Pinoccio/test-backpack-wifi/eagle/wifi-test-middle.pdf

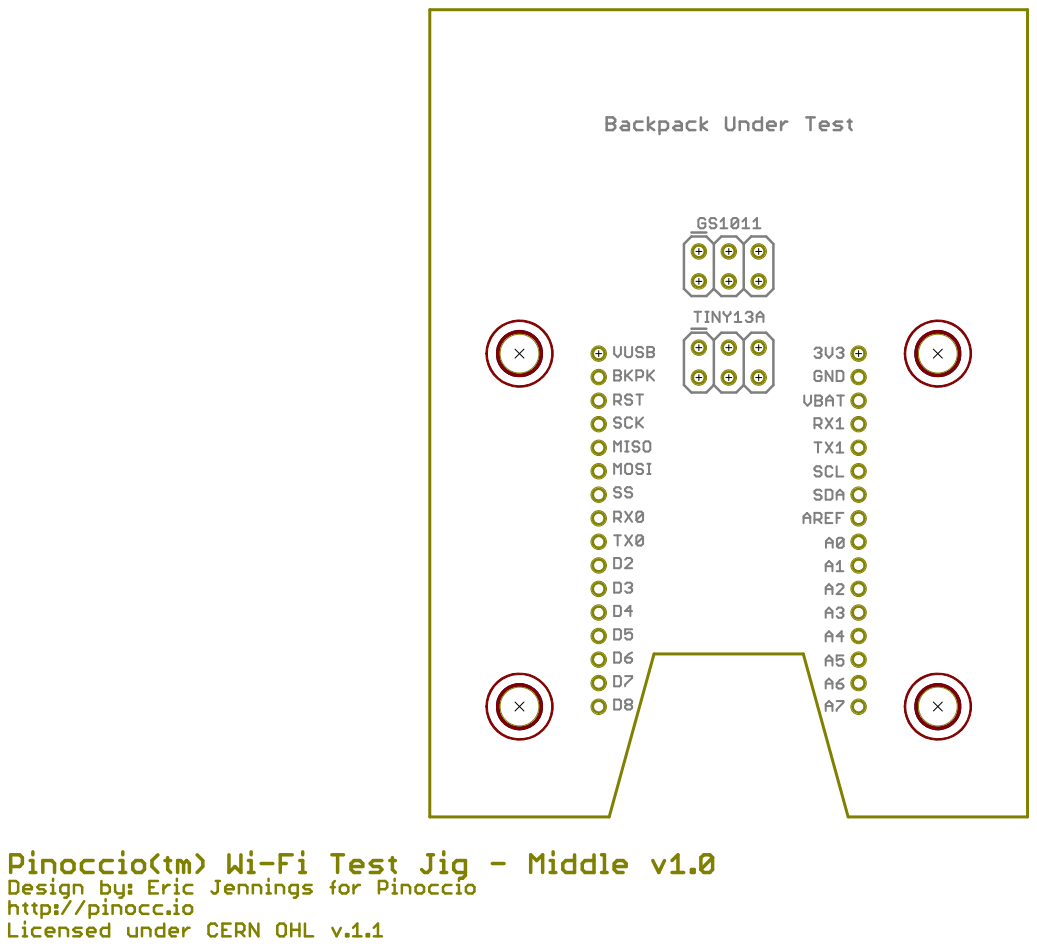
[picture p1: page 1]
