Pinoccio/test-backpack-wifi/eagle/wifi-test-top.pdf

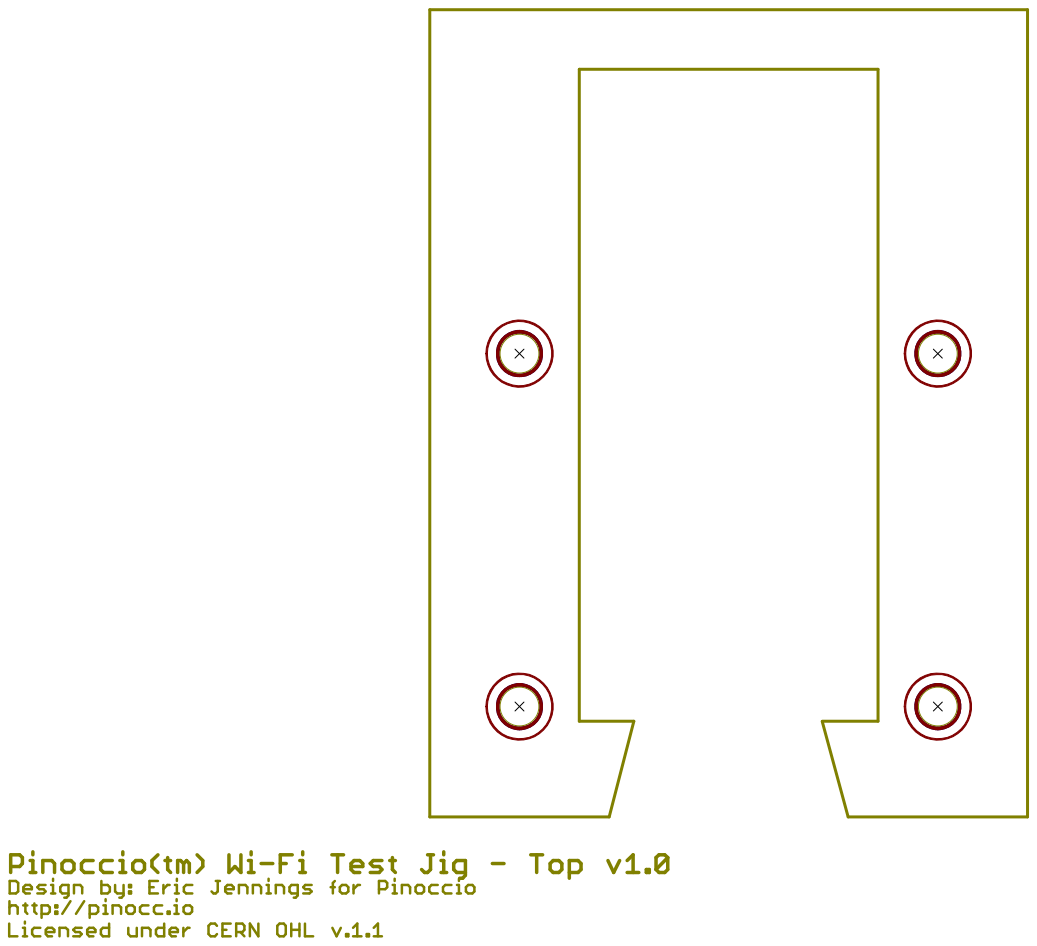
[picture p2: page 1]
