Pinoccio/test-backpack-wifi/eagle/wifi-test.pdf

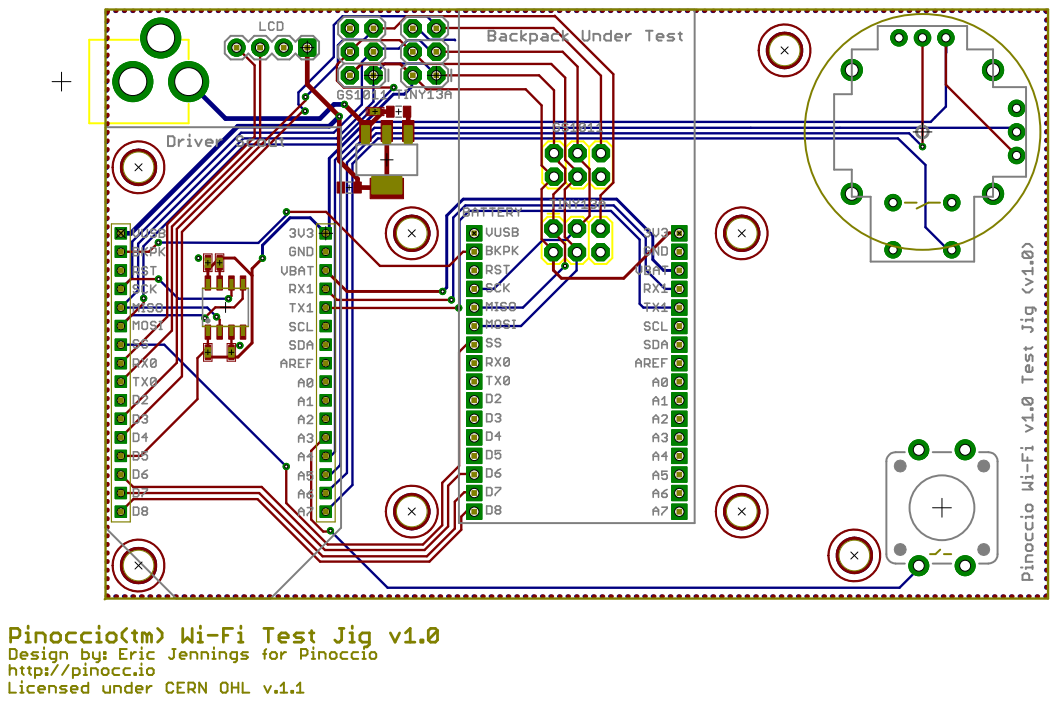
[picture p3: page 1]
