Pinoccio/test-backpack-wifi/eagle/wifi-test.brd

## EAGLE design eagle/wifi-test.brd (2014-05-23)

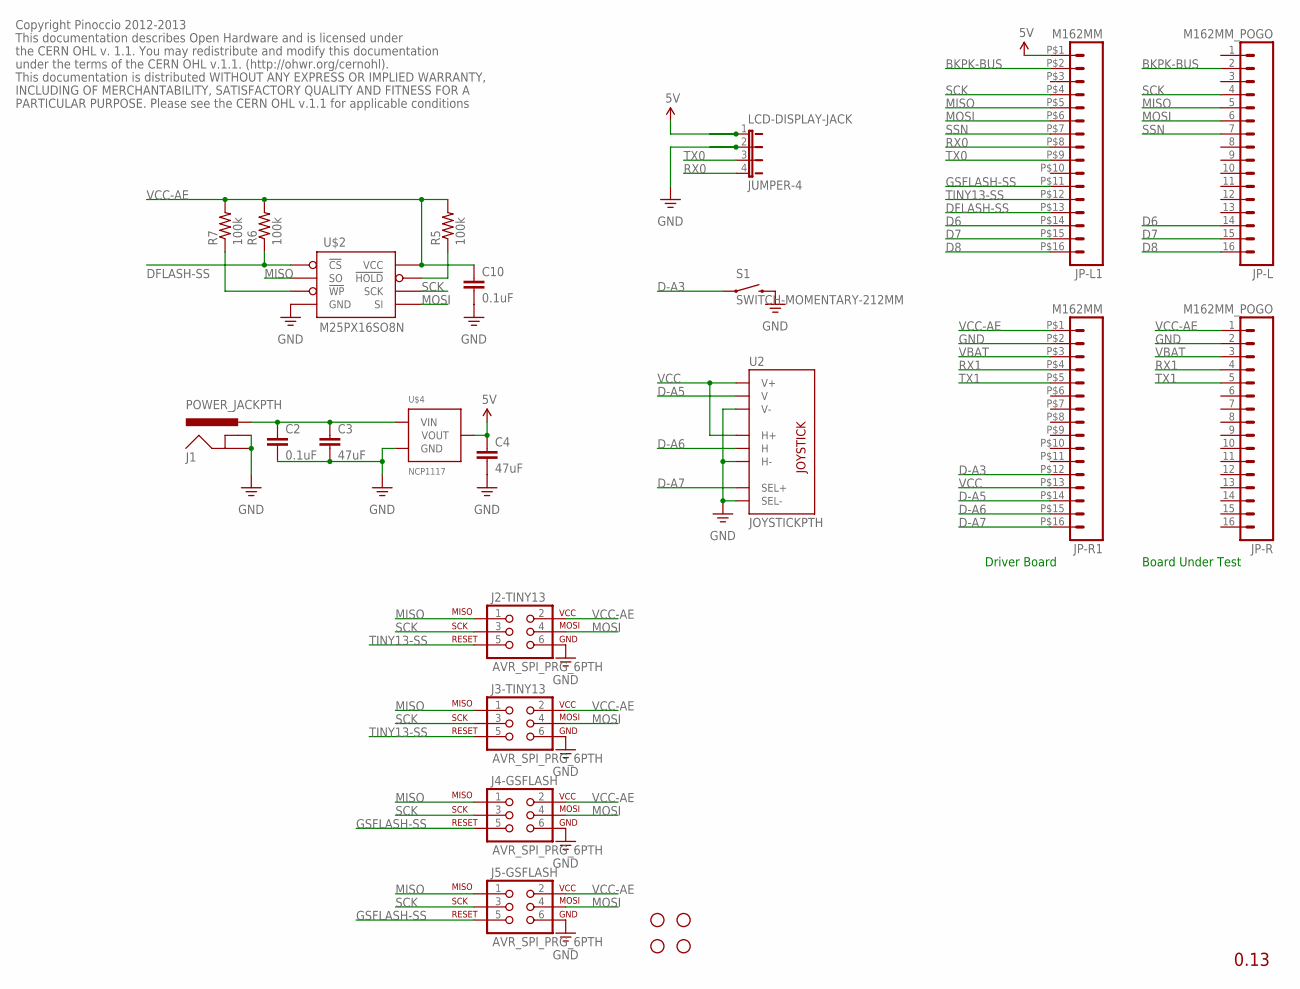
[picture p4: schematic wifi-test.sch]

Parts:
C2, C10: 0.1uF; 0402-CAP
C3, C4: 47uF; 0805
J1: POWER_JACKPTH; POWER_JACK_PTH
J2-TINY13, J3-TINY13, J4-GSFLASH, J5-GSFLASH: AVR_SPI_PRG_6PTH; 2X3
JP7, JP9, JP10, JP12: STAND-OFF
JP-L: M162MM_POGO; 1X16_2MM_POGO
JP-L1: M162MM; 1X16_2MM
JP-R: M162MM_POGO; 1X16_2MM_POGO
JP-R1: M162MM; 1X16_2MM
LCD-DISPLAY-JACK: JUMPER-4; 1X04
R5, R6, R7: 100k; 0402-RES
S1: SWITCH-MOMENTARY-212MM; TACTILE-PTH-12MM
U2: JOYSTICKPTH; JOYSTICK
U$2: M25PX16SO8N; SO8N
U$4: NCP1117; SOT223

Connections:
5V: C4.1, JP-L1.P$1 (1), LCD-DISPLAY-JACK.1, U$4.2 (VOUT), U$4.4 (VOUT)
BKPK-BUS: JP-L.2, JP-L1.P$2 (2)
D6: JP-L.14, JP-L1.P$14 (14)
D7: JP-L.15, JP-L1.P$15 (15)
D8: JP-L.16, JP-L1.P$16 (16)
D-A3: JP-R1.P$12 (12), S1.1
D-A5: JP-R1.P$14 (14), U2.V2 (V)
D-A6: JP-R1.P$15 (15), U2.H2 (H)
D-A7: JP-R1.P$16 (16), U2.B1A (SEL+)
DFLASH-SS: JP-L1.P$13 (13), R6.1, U$2.1 (!CS)
GND: C2.2, C3.2, C4.2, C10.2, J1.GND, J1.GNDBREAK, J2-TINY13.6, J3-TINY13.6, J4-GSFLASH.6, J5-GSFLASH.6, JP-R.2, JP-R1.P$2 (2), LCD-DISPLAY-JACK.2, S1.3 (2), U2.B2A (SEL-), U2.H3 (H-), U2.V3 (V-), U$2.4 (GND), U$4.1 (GND)
GSFLASH-SS: J4-GSFLASH.5, J5-GSFLASH.5, JP-L1.P$11 (11)
MISO: J2-TINY13.1, J3-TINY13.1, J4-GSFLASH.1, J5-GSFLASH.1, JP-L.5, JP-L1.P$5 (5), U$2.2 (SO)
MOSI: J2-TINY13.4, J3-TINY13.4, J4-GSFLASH.4, J5-GSFLASH.4, JP-L.6, JP-L1.P$6 (6), U$2.5 (SI)
unnamed: C2.1, C3.1, J1.PWR, U$4.3 (VIN)
unnamed: R7.1, U$2.3 (!WP)
unnamed: R5.1, U$2.7 (!HOLD)
RX0: JP-L1.P$8 (8), LCD-DISPLAY-JACK.4
RX1: JP-R.4, JP-R1.P$4 (4)
SCK: J2-TINY13.3, J3-TINY13.3, J4-GSFLASH.3, J5-GSFLASH.3, JP-L.4, JP-L1.P$4 (4), U$2.6 (SCK)
SSN: JP-L.7, JP-L1.P$7 (7)
TINY13-SS: J2-TINY13.5, J3-TINY13.5, JP-L1.P$12 (12)
TX0: JP-L1.P$9 (9), LCD-DISPLAY-JACK.3
TX1: JP-R.5, JP-R1.P$5 (5)
VBAT: JP-R.3, JP-R1.P$3 (3)
VCC: JP-R1.P$13 (13), U2.H1 (H+), U2.V1 (V+)
VCC-AE: C10.1, J2-TINY13.2, J3-TINY13.2, J4-GSFLASH.2, J5-GSFLASH.2, JP-R.1, JP-R1.P$1 (1), R5.2, R6.2, R7.2, U$2.8 (VCC)

Notes on the sheet:
0.13
Copyright Pinoccio 2012-2013
This documentation describes Open Hardware and is licensed under
the CERN OHL v. 1.1. You may redistribute and modify this documentation
under the terms of the CERN OHL v.1.1. (http://ohwr.org/cernohl).
This documentation is distributed WITHOUT ANY EXPRESS OR IMPLIED WARRANTY,
INCLUDING OF MERCHANTABILITY, SATISFACTORY QUALITY AND FITNESS FOR A
PARTICULAR PURPOSE. Please see the CERN OHL v.1.1 for applicable conditions
Driver Board
Board Under Test

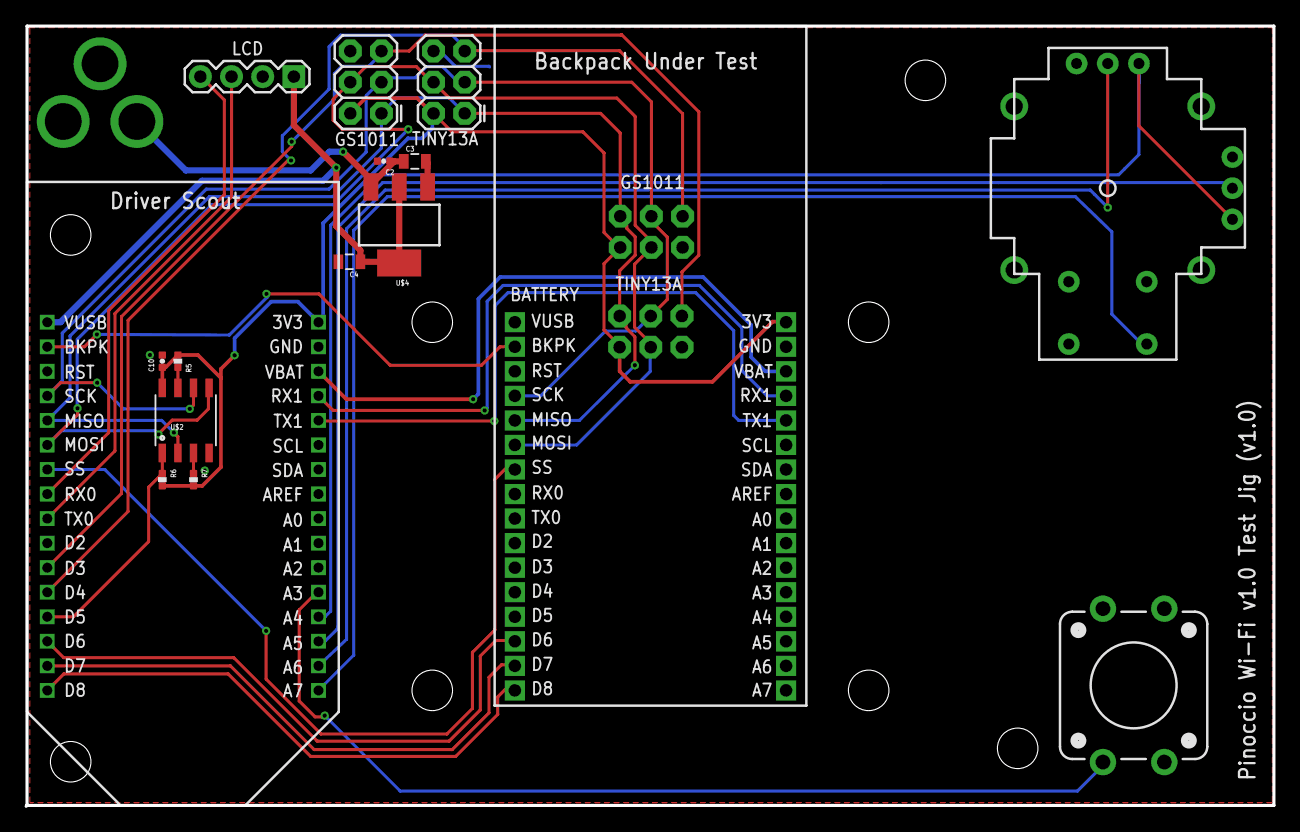
[picture p5: board wifi-test.brd from above]

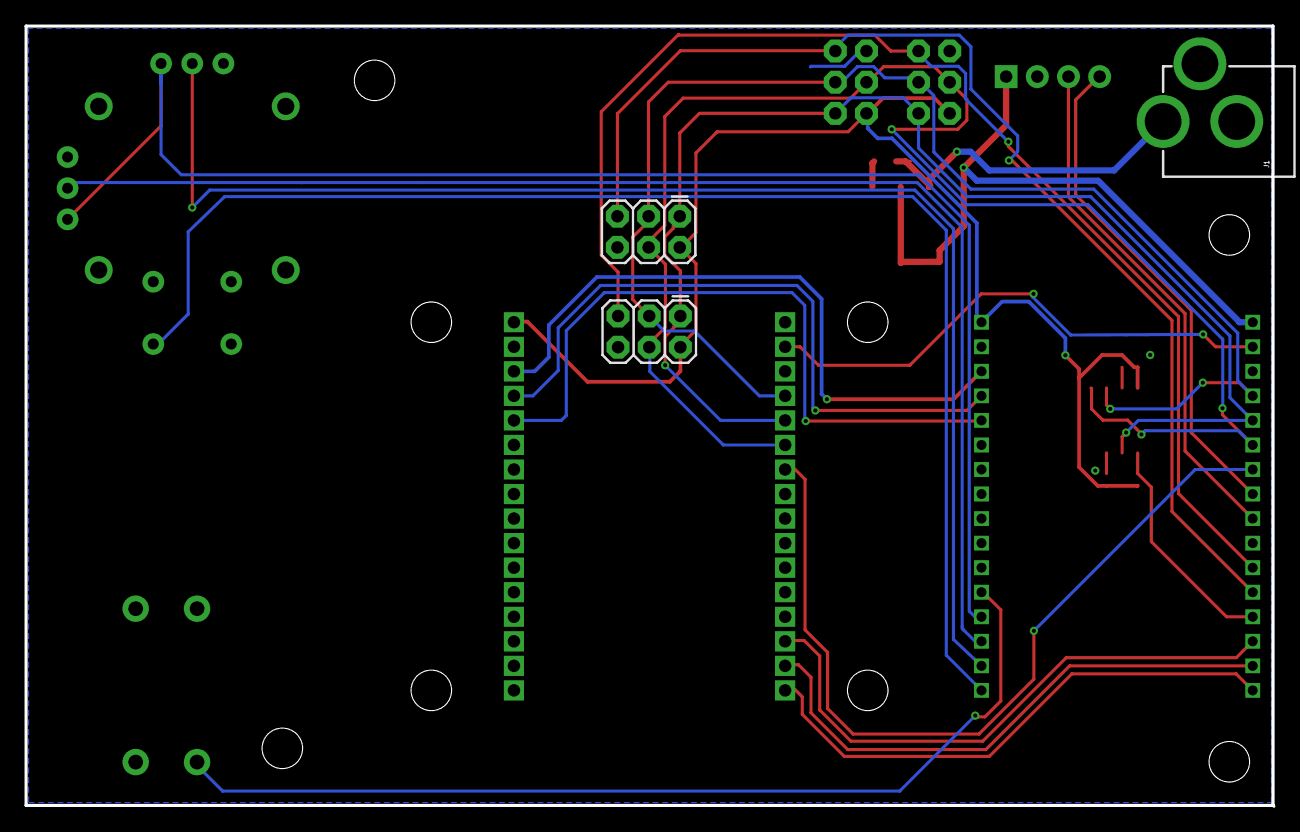
[picture p6: board wifi-test.brd from below]

Board: 2 copper layers, 101.6 x 63.5 mm, 29 parts (3 on the bottom side), 27 nets.

Other parts of the board:
JP8, JP11, JP13, JP14: STAND-OFF
