Pinoccio/test-backpack-wifi/firmware/Atmega_Board_Programmer/Atmega_Board_Programmer.ino

// Atmega chip programmer
// Author: Nick Gammon
// Date: 22nd May 2012
// Version: 1.19

// Version 1.1: Reset foundSig to -1 each time around the loop.
// Version 1.2: Put hex bootloader data into separate files
// Version 1.3: Added verify, and MD5 sums
// Version 1.4: Added signatures for ATmeag8U2/16U2/32U2 (7 May 2012)
// Version 1.5: Added signature for ATmega1284P (8 May 2012)
// Version 1.6: Allow sketches to read bootloader area (lockbyte: 0x2F)
// Version 1.7: Added choice of bootloaders for the Atmega328P (8 MHz or 16 MHz)
// Version 1.8: Output an 8 MHz clock on pin 9
// Version 1.9: Added support for Atmega1284P, and fixed some bugs
// Version 1.10: Corrected flash size for Atmega1284P.
// Version 1.11: Added support for Atmega1280. Removed MD5SUM stuff to make room.
// Version 1.12: Added signatures for ATtiny2313A, ATtiny4313, ATtiny13
// Version 1.13: Added signature for Atmega8A
// Version 1.14: Added bootloader for Atmega8
// Version 1.15: Removed extraneous 0xFF from some files
// Version 1.16: Added signature for Atmega328
// Version 1.17: Allowed for running on the Leonardo, Micro, etc.
// Version 1.18: Added timed writing for Atmega8
// Version 1.19: Changed Atmega1280 to use the Optiboot loader.

/*

 Copyright 2012 Nick Gammon.


 PERMISSION TO DISTRIBUTE

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

 LIMITATION OF LIABILITY

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
*/

#include <SPI.h>
#include <avr/pgmspace.h>

const byte VUSB_SWITCH = 5;
const byte MEGA_256RFR2_RESET = 6;
const byte MEGA_16U2_RESET = 7;
const byte DRIVER_FLASH_CS = SS;

const byte CLOCKOUT = SCK;
const byte RESET = MEGA_256RFR2_RESET;  // --> goes to reset on the target board

// number of items in an array
#define NUMITEMS(arg) ((unsigned int) (sizeof (arg) / sizeof (arg [0])))

// programming commands to send via SPI to the chip
enum {
    programEnable = 0xAC,

    // writes are preceded by programEnable
    chipErase = 0x80,
    writeLockByte = 0xE0,
    writeLowFuseByte = 0xA0,
    writeHighFuseByte = 0xA8,
    writeExtendedFuseByte = 0xA4,

    pollReady = 0xF0,

    programAcknowledge = 0x53,

    readSignatureByte = 0x30,
    readCalibrationByte = 0x38,

    readLowFuseByte = 0x50,       readLowFuseByteArg2 = 0x00,
    readExtendedFuseByte = 0x50,  readExtendedFuseByteArg2 = 0x08,
    readHighFuseByte = 0x58,      readHighFuseByteArg2 = 0x08,
    readLockByte = 0x58,          readLockByteArg2 = 0x00,

    readProgramMemory = 0x20,
    writeProgramMemory = 0x4C,
    loadExtendedAddressByte = 0x4D,
    loadProgramMemory = 0x40,

};

// structure to hold signature and other relevant data about each chip
typedef struct {
   byte sig [3];
   char * desc;
   unsigned long flashSize;
   unsigned int baseBootSize;
   byte * bootloader;
   unsigned long loaderStart;  // bytes
   unsigned int loaderLength;  // bytes
   unsigned long pageSize;     // bytes
   byte lowFuse, highFuse, extFuse, lockByte;
   byte timedWrites;    // if pollUntilReady won't work by polling the chip
} signatureType;

const unsigned long kb = 1024;

// hex bootloader data
#include "bootloader_atmega16u2.h"
#include "bootloader_atmega256rfr2.h"
#include "bootloader_attiny13a.h"

// see Atmega328 datasheet page 298
signatureType signatures [] =
  {
//     signature          description   flash size  bootloader size

  { { 0x1E, 0xA8, 0x02 }, "ATmega256RFR2",  256 * kb,   8 * kb,
        (byte*)atmega256rfr2,// loader image
        0x3E000,      // start address
        sizeof atmega256rfr2,
        256,          // page size (for committing)
        0xFF,         // fuse low byte: external clock, max start-up time
        0xD0,         // fuse high byte: SPI enable, boot into bootloader, 8192 byte bootloader
        0xFE,         // fuse extended byte: brown-out detection at 2.7V
        0x2F },       // lock bits: SPM is not allowed to write to the Boot Loader section.


  // Atmega32U2 family
  { { 0x1E, 0x93, 0x89 }, "ATmega8U2",    8 * kb,   512 },
  { { 0x1E, 0x94, 0x89 }, "ATmega16U2",  16 * kb,   1 * kb,
        (byte*)atmega16u2,// loader image
        0x0000,      // start address
        sizeof atmega16u2,
        64,          // page size (for committing)
        0xEF,         // fuse low byte:
        0xD9,         // fuse high byte:
        0xF4,         // fuse extended byte:
        0x2F },       // lock bits: SPM is not allowed to write to the Boot Loader section.

  { { 0x1E, 0x95, 0x8A }, "ATmega32U2",  32 * kb,   512 },

  // Atmega32U4 family
  { { 0x1E, 0x94, 0x88 }, "ATmega16U4",  16 * kb,   512 },
  { { 0x1E, 0x95, 0x87 }, "ATmega32U4",  32 * kb,   512 },


  // ATtiny13 family
  { { 0x1E, 0x90, 0x07 }, "ATtiny13A",     1 * kb, 0,
        (byte*)attiny13a,// loader image
        0x0000,      // start address
        sizeof attiny13a,
        32,          // page size (for committing)
        0x2A,         // fuse low byte:
        0xFB,         // fuse high byte:
        0xFF,         // fuse extended byte:
        0x2F },       // lock bits: SPM is not allowed to write to the Boot Loader section.

  };

// if signature found in above table, this is its index
int foundSig = -1;
byte lastAddressMSB = 0;

// execute one programming instruction ... b1 is command, b2, b3, b4 are arguments
//  processor may return a result on the 4th transfer, this is returned.
byte program (const byte b1, const byte b2 = 0, const byte b3 = 0, const byte b4 = 0)
  {
  SPI.transfer (b1);
  SPI.transfer (b2);
  SPI.transfer (b3);
  return SPI.transfer (b4);
  }

// read a byte from flash memory
byte readFlash (unsigned long addr)
  {
  byte high = (addr & 1) ? 0x08 : 0;  // set if high byte wanted
  addr >>= 1;  // turn into word address

  // set the extended (most significant) address byte if necessary
  byte MSB = (addr >> 16) & 0xFF;
  if (MSB != lastAddressMSB)
    {
    program (loadExtendedAddressByte, 0, MSB);
    lastAddressMSB = MSB;
    }

  return program (readProgramMemory | high, highByte (addr), lowByte (addr));
  }

// write a byte to the flash memory buffer (ready for committing)
byte writeFlash (unsigned long addr, const byte data)
  {
  byte high = (addr & 1) ? 0x08 : 0;  // set if high byte wanted
  addr >>= 1;  // turn into word address
  program (loadProgramMemory | high, 0, lowByte (addr), data);
  }

// show a byte in hex with leading zero and optional newline
void showHex (const byte b, const boolean newline = false, const boolean show0x = true)
  {
  if (show0x)
    Serial.print ("0x");
  // try to avoid using sprintf
  char buf [4] = { ((b >> 4) & 0x0F) | '0', (b & 0x0F) | '0', ' ' , 0 };
  if (buf [0] > '9')
    buf [0] += 7;
  if (buf [1] > '9')
    buf [1] += 7;
  Serial.print (buf);
  if (newline)
    Serial.println ();
  }

// convert a boolean to Yes/No
void showYesNo (const boolean b, const boolean newline = false)
  {
  if (b)
    Serial.print ("Yes");
  else
    Serial.print ("No");
  if (newline)
    Serial.println ();
  }

// poll the target device until it is ready to be programmed
void pollUntilReady() {
  if (signatures [foundSig].timedWrites) {
    delay (10);  // at least 2 x WD_FLASH which is 4.5 mS
  } else {
    while ((program(pollReady) & 1) == 1) {}  // wait till ready
  }
}

// commit page
void commitPage(unsigned long addr) {
  //Serial.print ("Committing page starting at 0x");
  //Serial.println (addr, HEX);

  addr >>= 1;  // turn into word address

  // set the extended (most significant) address byte if necessary
  byte MSB = (addr >> 16) & 0xFF;
  if (MSB != lastAddressMSB) {
    program (loadExtendedAddressByte, 0, MSB);
    lastAddressMSB = MSB;
  }

  program(writeProgramMemory, highByte (addr), lowByte (addr));
  pollUntilReady();
  }

// write specified value to specified fuse/lock byte
void writeFuse(const byte newValue, const byte instruction) {
  if (newValue == 0) {
    return;  // ignore
  }

  program(programEnable, instruction, 0, newValue);
  pollUntilReady();
}

void getFuseBytes() {
  Serial.print ("LFuse = ");
  showHex (program (readLowFuseByte, readLowFuseByteArg2), true);
  Serial.print ("HFuse = ");
  showHex (program (readHighFuseByte, readHighFuseByteArg2), true);
  Serial.print ("EFuse = ");
  showHex (program (readExtendedFuseByte, readExtendedFuseByteArg2), true);
  Serial.print ("Lock byte = ");
  showHex (program (readLockByte, readLockByteArg2), true);
  Serial.print ("Clock calibration = ");
  showHex (program (readCalibrationByte), true);
}

// burn the bootloader to the target device
void writeBootloader() {

  if (signatures[foundSig].bootloader == 0) {
    Serial.println("No bootloader support for this device.");
    return;
  }

  int i;

  byte lFuse = program(readLowFuseByte, readLowFuseByteArg2);

  byte newlFuse = signatures[foundSig].lowFuse;
  byte newhFuse = signatures[foundSig].highFuse;
  byte newextFuse = signatures[foundSig].extFuse;
  byte newlockByte = signatures[foundSig].lockByte;


  unsigned long addr = signatures[foundSig].loaderStart;
  unsigned int  len = signatures[foundSig].loaderLength;
  unsigned long pagesize = signatures[foundSig].pageSize;
  unsigned long pagemask = ~(pagesize - 1);
  byte * bootloader = signatures[foundSig].bootloader;


  Serial.print("Bootloader page size = ");
  Serial.println(pagesize);
  Serial.print("Bootloader address = 0x");
  Serial.println(addr, HEX);
  Serial.print("Bootloader length = ");
  Serial.print(len);
  Serial.println(" bytes.");

  byte subcommand = 'U';

  unsigned long oldPage = addr & pagemask;

  Serial.println("Type 'V' to verify, or 'G' to program the chip with the bootloader ...");
  char command;
  do {
    command = toupper(Serial.read());
  } while (command != 'G' && command != 'V');

  if (command == 'G') {
    Serial.println("Erasing chip ...");
    program(programEnable, chipErase);   // erase it
    delay(20);  // for Atmega8
    pollUntilReady();
    Serial.println("Writing bootloader ...");

    for (i = 0; i < len; i += 2) {
      unsigned long thisPage = (addr + i) & pagemask;
      // page changed? commit old one
      if (thisPage != oldPage) {
        commitPage(oldPage);
        oldPage = thisPage;
      }
      writeFlash(addr + i, pgm_read_byte(bootloader + i));
      writeFlash(addr + i + 1, pgm_read_byte(bootloader + i + 1));
      /*
      Serial.print("Wrote to address ");
      showHex(addr + i);
      Serial.print(": ");
      showHex(pgm_read_byte(bootloader + i));
      Serial.println("");
      Serial.print("Wrote to address ");
      showHex(addr + i + 1);
      Serial.print(": ");
      showHex(pgm_read_byte(bootloader + i + 1));
      Serial.println("");
      */
    }  // end while doing each word

    // commit final page
    commitPage(oldPage);
    Serial.println("Written.");
  }

  Serial.println("Verifying ...");

  // count errors
  unsigned int errors = 0;
  // check each byte
  for (i = 0; i < signatures[foundSig].loaderLength; i++) {
    byte found = readFlash(addr + i);
    byte expected = pgm_read_byte(bootloader + i);
    if (found != expected) {
      if (errors <= 100) {
        Serial.print("Verification error at address ");
        Serial.print(addr + i, HEX);
        Serial.print(". Got: ");
        showHex(found);
        Serial.print(" Expected: ");
        showHex(expected, true);
      }
      errors++;
    }
  }

  if (errors == 0) {
    Serial.println("No errors found.");
  } else {
    Serial.print(errors, DEC);
    Serial.println(" verification error(s).");
    if (errors > 100) {
      Serial.println ("First 100 shown.");
    }
  //return;  // don't change fuses if errors
  }

  if (command == 'G') {
    Serial.println ("Writing fuses ...");

    writeFuse(newlFuse, writeLowFuseByte);
    writeFuse(newhFuse, writeHighFuseByte);
    writeFuse(newextFuse, writeExtendedFuseByte);
    writeFuse(newlockByte, writeLockByte);

    // confirm them
    getFuseBytes();
  }

  Serial.println ("Done.");
}


void startProgramming() {
  byte confirm;
  pinMode (RESET, OUTPUT);
  //pinMode (CLOCKOUT, OUTPUT);

  // we are in sync if we get back programAcknowledge on the third byte
  do {
    delay (100);
    // ensure SCK low
    digitalWrite (SCK, LOW);
    // then pulse reset, see page 309 of datasheet
    digitalWrite (RESET, HIGH);
    delay (1);  // pulse for at least 2 clock cycles
    digitalWrite (RESET, LOW);
    delay (25);  // wait at least 20 mS
    SPI.transfer (programEnable);
    SPI.transfer (programAcknowledge);
    confirm = SPI.transfer (0);
    SPI.transfer (0);
  } while (confirm != programAcknowledge);

  Serial.println ("Entered programming mode OK.");
}

void getSignature ()
  {
  foundSig = -1;
  lastAddressMSB = 0;

  byte sig [3];
  Serial.print ("Signature = ");
  for (byte i = 0; i < 3; i++)
    {
    sig [i] = program (readSignatureByte, 0, i);
    showHex (sig [i]);
    }  // end for each signature byte
  Serial.println ();

  for (int j = 0; j < NUMITEMS (signatures); j++)
    {
    if (memcmp (sig, signatures [j].sig, sizeof sig) == 0)
      {
      foundSig = j;
      Serial.print ("Processor = ");
      Serial.println (signatures [j].desc);
      Serial.print ("Flash memory size = ");
      Serial.print (signatures [j].flashSize, DEC);
      Serial.println (" bytes.");
      if (signatures [foundSig].timedWrites)
        Serial.println ("Writes are timed, not polled.");
      return;
      }
    }

  Serial.println ("Unrecogized signature.");
  }

void readProgram ()
  {
  unsigned long addr = 0;
  unsigned int  len = 256;
  Serial.println ();
  Serial.println ("First 256 bytes of program memory:");
  Serial.println ();

  for (int i = 0; i < len; i++)
    {
    // show address
    if (i % 16 == 0)
      {
      Serial.print (addr + i, HEX);
      Serial.print (": ");
      }
    showHex (readFlash (addr + i));
    // new line every 16 bytes
    if (i % 16 == 15)
      Serial.println ();
    }

  Serial.println ();

  }

void showHex (const byte b, const boolean newline = false)
  {
  // try to avoid using sprintf
  char buf [4] = { ((b >> 4) & 0x0F) | '0', (b & 0x0F) | '0', ' ' , 0 };
  if (buf [0] > '9')
    buf [0] += 7;
  if (buf [1] > '9')
    buf [1] += 7;
  Serial.print (buf);
  if (newline)
    Serial.println ();
  }


void setup ()
  {

  pinMode(VCC_ENABLE, OUTPUT);
  digitalWrite(VCC_ENABLE, LOW);
  pinMode(VUSB_SWITCH, OUTPUT);
  digitalWrite(VUSB_SWITCH, LOW);
  
  pinMode(MEGA_256RFR2_RESET, OUTPUT);
  digitalWrite(MEGA_256RFR2_RESET, HIGH);
  pinMode(MEGA_16U2_RESET, OUTPUT);
  digitalWrite(MEGA_16U2_RESET, HIGH);
  pinMode(DRIVER_FLASH_CS, OUTPUT);
  digitalWrite(DRIVER_FLASH_CS, HIGH);
  
  digitalWrite(VUSB_SWITCH, HIGH);
  
  Serial.begin (115200);
  while (!Serial) ;  // for Leonardo, Micro etc.
  Serial.println ();
  Serial.println ("Atmega chip programmer.");
  Serial.println ("Written by Nick Gammon.");

  digitalWrite (RESET, HIGH);  // ensure SS stays high for now
  SPI.begin ();

  // slow down SPI for benefit of slower processors like the Attiny
  SPI.setClockDivider (SPI_CLOCK_DIV64);

  //pinMode (CLOCKOUT, OUTPUT);

  // set up Timer 1
  TCCR1A = _BV (COM1A0);  // toggle OC1A on Compare Match
  TCCR1B = _BV(WGM12) | _BV(CS10);   // CTC, no prescaling
  OCR1A =  0;       // output every cycle

 }

void loop ()
  {

  startProgramming ();
  getSignature ();
  getFuseBytes ();

  // if we found a signature try to write a bootloader
  if (foundSig != -1)
    writeBootloader ();

  readProgram ();

  // release reset
  digitalWrite (RESET, HIGH);

  Serial.println ("Type 'C' when ready to continue with another chip ...");
  while (toupper (Serial.read ()) != 'C')
    {}

  }
