Pinoccio/test-backpack-wifi/firmware/DriverFlashWriter/serialwrite.py

import serial
import time
import os
import binascii
import sys

filename = "s2w-2.5.113_Dec_2013_12_35_28/WFW-REL-2_5_1.bin"

print "Connecting to serial"
ser = serial.Serial("/dev/tty.usbmodemfa131", 115200, serial.EIGHTBITS, serial.PARITY_NONE, serial.STOPBITS_ONE, 5)

fp = open(filename)
size = os.path.getsize(filename)
print "Opened following hex file for flashing: ", fp.name, "(", size, "bytes )"
position = 0;

print "Waiting for Pinoccio:"
time.sleep(5)
ret = ""
running = True

while ser.inWaiting() > 0:
  ret += ser.read(1)
print ret

while (running and position < size):

  hex = fp.read(1)
  #val = int(hex, 16)
  print position, ") sent - 0x", hex.encode('hex')
  ser.write(hex)

  position+=1

  if (position % 32 == 0):

    ret = ser.read(2)
    if (ret != "OK"):
      print "FAIL: no response from Scout"
      ret += ser.read(300)
      print ret
      running = False
    else:
      print ret

    ser.flushInput()

  if (position >= size):
    print "Done"
    running = False
