Pinoccio/test-backpack-wifi/firmware/Atmega_Board_Programmer/bootloader_atmega16u2.h

// File =  Arduino-usbserial.hex
// Loader start: 0, length: 8192
// MD5 sum = 20 36 42 3C 45 56 80 D7 07 05 BB 21 64 0F 44 12 

const byte PROGMEM atmega16u2 [] = {
0x77, 0xC0, 0x00, 0x00, 0x90, 0xC0, 0x00, 0x00, 0x8E, 0xC0, 0x00, 0x00, 0x8C, 0xC0, 0x00, 0x00, 
0x8A, 0xC0, 0x00, 0x00, 0x88, 0xC0, 0x00, 0x00, 0x86, 0xC0, 0x00, 0x00, 0x84, 0xC0, 0x00, 0x00, 
0x82, 0xC0, 0x00, 0x00, 0x80, 0xC0, 0x00, 0x00, 0x7E, 0xC0, 0x00, 0x00, 0xF9, 0xC3, 0x00, 0x00, 
0x9E, 0xC4, 0x00, 0x00, 0x78, 0xC0, 0x00, 0x00, 0x76, 0xC0, 0x00, 0x00, 0x74, 0xC0, 0x00, 0x00, 
0x72, 0xC0, 0x00, 0x00, 0x70, 0xC0, 0x00, 0x00, 0x6E, 0xC0, 0x00, 0x00, 0x6C, 0xC0, 0x00, 0x00, 
0x6A, 0xC0, 0x00, 0x00, 0x68, 0xC0, 0x00, 0x00, 0x66, 0xC0, 0x00, 0x00, 0xAD, 0xC1, 0x00, 0x00, 
0x62, 0xC0, 0x00, 0x00, 0x60, 0xC0, 0x00, 0x00, 0x5E, 0xC0, 0x00, 0x00, 0x5C, 0xC0, 0x00, 0x00, 
0x5A, 0xC0, 0x00, 0x00, 0x12, 0x03, 0x50, 0x00, 0x69, 0x00, 0x6E, 0x00, 0x6F, 0x00, 0x63, 0x00, 
0x63, 0x00, 0x69, 0x00, 0x6F, 0x00, 0x00, 0x00, 0x12, 0x03, 0x50, 0x00, 0x69, 0x00, 0x6E, 0x00, 
0x6F, 0x00, 0x63, 0x00, 0x63, 0x00, 0x69, 0x00, 0x6F, 0x00, 0x00, 0x00, 0x04, 0x03, 0x09, 0x04, 
0x09, 0x02, 0x3E, 0x00, 0x02, 0x01, 0x00, 0xC0, 0xFA, 0x09, 0x04, 0x00, 0x00, 0x01, 0x02, 0x02, 
0x01, 0x00, 0x05, 0x24, 0x00, 0x01, 0x10, 0x04, 0x24, 0x02, 0x06, 0x05, 0x24, 0x06, 0x00, 0x01, 
0x07, 0x05, 0x82, 0x03, 0x08, 0x00, 0xFF, 0x09, 0x04, 0x01, 0x00, 0x02, 0x0A, 0x00, 0x00, 0x00, 
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
0x9F, 0x01, 0x9F, 0xBF, 0x80, 0xE0, 0x91, 0xE0, 0xF2, 0xD5, 0xFA, 0x94, 0xF1, 0x10, 0xE2, 0xCF, 
0x80, 0x91, 0x18, 0x01, 0x88, 0x23, 0x41, 0xF0, 0x80, 0x91, 0x18, 0x01, 0x81, 0x50, 0x80, 0x93, 
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
}; // end of Arduino_usbserial_hex
