Pinoccio/test-backpack-wifi/firmware/Atmega_Board_Programmer/bootloader_atmega2560_v2.h

// File =  stk500boot_v2_mega2560_fixes_watchdog_problem.hex
// Loader start: 3E000, length: 8192
// MD5 sum = 8A F4 7A 29 43 A0 D8 7C DB ED 09 A3 8F 40 24 1E 
// https://github.com/arduino/Arduino-stk500v2-bootloader/blob/master/goodHexFiles/stk500boot_v2_mega2560.hex

const byte PROGMEM atmega2560_v2 [] = {
0x0D, 0x94, 0x89, 0xF1, 0x0D, 0x94, 0xB2, 0xF1, 0x0D, 0x94, 0xB2, 0xF1, 0x0D, 0x94, 0xB2, 0xF1, 
0x0D, 0x94, 0xB2, 0xF1, 0x0D, 0x94, 0xB2, 0xF1, 0x0D, 0x94, 0xB2, 0xF1, 0x0D, 0x94, 0xB2, 0xF1, 
0x0D, 0x94, 0xB2, 0xF1, 0x0D, 0x94, 0xB2, 0xF1, 0x0D, 0x94, 0xB2, 0xF1, 0x0D, 0x94, 0xB2, 0xF1, 
0x0D, 0x94, 0xB2, 0xF1, 0x0D, 0x94, 0xB2, 0xF1, 0x0D, 0x94, 0xB2, 0xF1, 0x0D, 0x94, 0xB2, 0xF1, 
0x0D, 0x94, 0xB2, 0xF1, 0x0D, 0x94, 0xB2, 0xF1, 0x0D, 0x94, 0xB2, 0xF1, 0x0D, 0x94, 0xB2, 0xF1, 
0x0D, 0x94, 0xB2, 0xF1, 0x0D, 0x94, 0xB2, 0xF1, 0x0D, 0x94, 0xB2, 0xF1, 0x0D, 0x94, 0xB2, 0xF1, 
0x0D, 0x94, 0xB2, 0xF1, 0x0D, 0x94, 0xB2, 0xF1, 0x0D, 0x94, 0xB2, 0xF1, 0x0D, 0x94, 0xB2, 0xF1, 
0x0D, 0x94, 0xB2, 0xF1, 0x0D, 0x94, 0xB2, 0xF1, 0x0D, 0x94, 0xB2, 0xF1, 0x0D, 0x94, 0xB2, 0xF1, 
0x0D, 0x94, 0xB2, 0xF1, 0x0D, 0x94, 0xB2, 0xF1, 0x0D, 0x94, 0xB2, 0xF1, 0x0D, 0x94, 0xB2, 0xF1, 
0x0D, 0x94, 0xB2, 0xF1, 0x0D, 0x94, 0xB2, 0xF1, 0x0D, 0x94, 0xB2, 0xF1, 0x0D, 0x94, 0xB2, 0xF1, 
0x0D, 0x94, 0xB2, 0xF1, 0x0D, 0x94, 0xB2, 0xF1, 0x0D, 0x94, 0xB2, 0xF1, 0x0D, 0x94, 0xB2, 0xF1, 
0x0D, 0x94, 0xB2, 0xF1, 0x0D, 0x94, 0xB2, 0xF1, 0x0D, 0x94, 0xB2, 0xF1, 0x0D, 0x94, 0xB2, 0xF1, 
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
0x45, 0x00, 0x45, 0x45, 0x20, 0x65, 0x72, 0x72, 0x20, 0x63, 0x6E, 0x74, 0x3D, 0x00, 0x50, 0x4F, 
0x52, 0x54, 0x00, 0x30, 0x3D, 0x5A, 0x65, 0x72, 0x6F, 0x20, 0x61, 0x64, 0x64, 0x72, 0x00, 0x3F, 
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
}; // end of atmega2560_v2
