Pinoccio/test-backpack-wifi/firmware/Atmega_Board_Programmer/bootloader_lilypad328.h

// File =  ATmegaBOOT_168_atmega328_pro_8MHz.hex
// Loader start: 7800, length: 2048
// MD5 sum = 27 EB 87 14 5D 45 D4 D8 41 44 52 CE 0A 2B 8C 5F 

const byte PROGMEM ATmegaBOOT_168_atmega328_pro_8MHz_hex [] = {
0x0C, 0x94, 0x34, 0x3C, 0x0C, 0x94, 0x51, 0x3C, 0x0C, 0x94, 0x51, 0x3C, 0x0C, 0x94, 0x51, 0x3C, 
0x0C, 0x94, 0x51, 0x3C, 0x0C, 0x94, 0x51, 0x3C, 0x0C, 0x94, 0x51, 0x3C, 0x0C, 0x94, 0x51, 0x3C, 
0x0C, 0x94, 0x51, 0x3C, 0x0C, 0x94, 0x51, 0x3C, 0x0C, 0x94, 0x51, 0x3C, 0x0C, 0x94, 0x51, 0x3C, 
0x0C, 0x94, 0x51, 0x3C, 0x0C, 0x94, 0x51, 0x3C, 0x0C, 0x94, 0x51, 0x3C, 0x0C, 0x94, 0x51, 0x3C, 
0x0C, 0x94, 0x51, 0x3C, 0x0C, 0x94, 0x51, 0x3C, 0x0C, 0x94, 0x51, 0x3C, 0x0C, 0x94, 0x51, 0x3C, 
0x0C, 0x94, 0x51, 0x3C, 0x0C, 0x94, 0x51, 0x3C, 0x0C, 0x94, 0x51, 0x3C, 0x0C, 0x94, 0x51, 0x3C, 
0x0C, 0x94, 0x51, 0x3C, 0x0C, 0x94, 0x51, 0x3C, 0x11, 0x24, 0x1F, 0xBE, 0xCF, 0xEF, 0xD8, 0xE0, 
0xDE, 0xBF, 0xCD, 0xBF, 0x11, 0xE0, 0xA0, 0xE0, 0xB1, 0xE0, 0xEA, 0xE8, 0xFF, 0xE7, 0x02, 0xC0, 
0x05, 0x90, 0x0D, 0x92, 0xA2, 0x30, 0xB1, 0x07, 0xD9, 0xF7, 0x12, 0xE0, 0xA2, 0xE0, 0xB1, 0xE0, 
0x01, 0xC0, 0x1D, 0x92, 0xAD, 0x30, 0xB1, 0x07, 0xE1, 0xF7, 0x0E, 0x94, 0x2D, 0x3D, 0x0C, 0x94, 
0xC3, 0x3F, 0x0C, 0x94, 0x00, 0x3C, 0x98, 0x2F, 0x95, 0x95, 0x95, 0x95, 0x95, 0x95, 0x95, 0x95, 
0x90, 0x5D, 0x8F, 0x70, 0x8A, 0x30, 0x7C, 0xF0, 0x28, 0x2F, 0x29, 0x5A, 0x80, 0x91, 0xC0, 0x00, 
0x85, 0xFF, 0xFC, 0xCF, 0x90, 0x93, 0xC6, 0x00, 0x80, 0x91, 0xC0, 0x00, 0x85, 0xFF, 0xFC, 0xCF, 
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
0x6F, 0x92, 0x7F, 0x92, 0x8F, 0x92, 0x9F, 0x92, 0xAF, 0x92, 0xBF, 0x92, 0xCF, 0x92, 0xDF, 0x92, 
0xEF, 0x92, 0xFF, 0x92, 0x0F, 0x93, 0x1F, 0x93, 0xCF, 0x93, 0xDF, 0x93, 0x00, 0x00, 0x82, 0xE0, 
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
}; // end of ATmegaBOOT_168_atmega328_pro_8MHz_hex
