Pinoccio/test-backpack-wifi/firmware/WifiTestSuite/flash_attiny13a.h

const byte PROGMEM attiny13a_flash [] = {
0x09, 0xC0, 0xFD, 0xC0, 0x0D, 0xC0, 0xB3, 0xC1, 0x0B, 0xC0, 0x0A, 0xC0, 0x2E, 0xC1, 0x2B, 0xC1,
0x07, 0xC0, 0x06, 0xC0, 0x11, 0x24, 0x1F, 0xBE, 0xCF, 0xE9, 0xCD, 0xBF, 0xC7, 0xD1, 0xC9, 0xC1,
0xEF, 0xCF, 0xE1, 0x99, 0xFE, 0xCF, 0x8E, 0xBB, 0xE0, 0x9A, 0x8D, 0xB3, 0x08, 0x95, 0x71, 0x2C,
0x84, 0xE0, 0x68, 0x22, 0x04, 0xB6, 0x03, 0xFE, 0x61, 0x2C, 0x8D, 0xEF, 0x88, 0xBB, 0x81, 0xE0,
0x85, 0xBD, 0x18, 0xE7, 0x85, 0xEA, 0x89, 0xBD, 0x8E, 0xE8, 0x86, 0xBF, 0x80, 0xE4, 0x8B, 0xBF,
0x82, 0xE0, 0x83, 0xBF, 0x14, 0xBE, 0x82, 0xE2, 0x85, 0xBF, 0x78, 0x94, 0x08, 0x95, 0xCF, 0x93,
0x88, 0xE4, 0x78, 0x12, 0x9A, 0xC0, 0x88, 0x2D, 0x84, 0x30, 0xD1, 0xF1, 0x40, 0xF4, 0x82, 0x30,
0x09, 0xF4, 0x6E, 0xC0, 0x30, 0xF5, 0x81, 0x30, 0x09, 0xF0, 0x8D, 0xC0, 0x0B, 0xC0, 0x86, 0x30,
0xC9, 0xF1, 0x08, 0xF4, 0x7A, 0xC0, 0x87, 0x30, 0x09, 0xF4, 0x40, 0xC0, 0x88, 0x30, 0x09, 0xF0,
0x82, 0xC0, 0x7D, 0xC0, 0x82, 0x2D, 0x8E, 0x3F, 0x59, 0xF4, 0xC2, 0xE0, 0x8C, 0x2E, 0x86, 0x2D,
0x8B, 0x7F, 0x98, 0xE1, 0x69, 0x2E, 0x68, 0x2A, 0x23, 0xE0, 0x42, 0x2E, 0x51, 0x2C, 0x73, 0xC0,
0x62, 0xFE, 0x05, 0xC0, 0x25, 0x10, 0x03, 0xC0, 0xB3, 0xE0, 0x8B, 0x2E, 0x6A, 0xC0, 0x71, 0x2C,
0x6A, 0xC0, 0x82, 0x2D, 0x81, 0x30, 0x19, 0xF0, 0x82, 0x30, 0x39, 0xF4, 0x03, 0xC0, 0xA4, 0xE0,
0x8A, 0x2E, 0x5F, 0xC0, 0xF6, 0xE0, 0x8F, 0x2E, 0x5C, 0xC0, 0xE4, 0xE0, 0x9E, 0x2E, 0x59, 0xC0,
0x82, 0x2D, 0x42, 0x2C, 0x90, 0xE1, 0x69, 0x2A, 0x75, 0xE0, 0x87, 0x2E, 0x80, 0x34, 0x08, 0xF4,
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
0x01, 0x77, 0x69, 0x66, 0xE9, 0x07, 0x0F, 0x7C, 0x04, 0x0E, 0x70, 0x67, 0xED, 0x04, 0x0D, 0x72, 
0x64, 0xF9, 0x02, 0x13, 0x39, 0xCA, 0xE1, 0x01, 0x73, 0xE4, 0x07, 0x10, 0xA9, 0x02, 0x11, 0x00, 
0x00, 0xCB, 0x01, 0x65, 0x65, 0xF0, 0x07, 0x07, 0xC2, 0x02, 0x11, 0x05, 0x80, 0x9E, 0x13, 0x97
}; 
