Pinoccio/test-backpack-wifi/firmware/Atmega_Board_Programmer/bootloader_atmega8.h

// File =  ATmegaBOOT.hex
// Loader start: 1C00, length: 1024
// MD5 sum = 98 6D CF BB 55 E1 22 1E E4 3C C2 07 B2 2B 46 AE 

const byte PROGMEM atmega8_hex [] = {
0x12, 0xC0, 0x2B, 0xC0, 0x2A, 0xC0, 0x29, 0xC0, 0x28, 0xC0, 0x27, 0xC0, 0x26, 0xC0, 0x25, 0xC0, 
0x24, 0xC0, 0x23, 0xC0, 0x22, 0xC0, 0x21, 0xC0, 0x20, 0xC0, 0x1F, 0xC0, 0x1E, 0xC0, 0x1D, 0xC0, 
0x1C, 0xC0, 0x1B, 0xC0, 0x1A, 0xC0, 0x11, 0x24, 0x1F, 0xBE, 0xCF, 0xE5, 0xD4, 0xE0, 0xDE, 0xBF, 
0xCD, 0xBF, 0x10, 0xE0, 0xA0, 0xE6, 0xB0, 0xE0, 0xE8, 0xEE, 0xFF, 0xE1, 0x02, 0xC0, 0x05, 0x90, 
0x0D, 0x92, 0xA2, 0x36, 0xB1, 0x07, 0xD9, 0xF7, 0x11, 0xE0, 0xA2, 0xE6, 0xB0, 0xE0, 0x01, 0xC0, 
0x1D, 0x92, 0xAA, 0x36, 0xB1, 0x07, 0xE1, 0xF7, 0x4F, 0xC0, 0xD2, 0xCF, 0xEF, 0x92, 0xFF, 0x92, 
0x0F, 0x93, 0x1F, 0x93, 0xEE, 0x24, 0xFF, 0x24, 0x87, 0x01, 0x13, 0xC0, 0x08, 0x94, 0xE1, 0x1C, 
0xF1, 0x1C, 0x01, 0x1D, 0x11, 0x1D, 0x81, 0xE0, 0xE8, 0x16, 0x82, 0xE1, 0xF8, 0x06, 0x8A, 0xE7, 
0x08, 0x07, 0x80, 0xE0, 0x18, 0x07, 0x28, 0xF0, 0xE0, 0x91, 0x62, 0x00, 0xF0, 0x91, 0x63, 0x00, 
0x09, 0x95, 0x5F, 0x9B, 0xEB, 0xCF, 0x8C, 0xB1, 0x99, 0x27, 0x87, 0xFD, 0x90, 0x95, 0x1F, 0x91, 
0x0F, 0x91, 0xFF, 0x90, 0xEF, 0x90, 0x08, 0x95, 0x5D, 0x9B, 0xFE, 0xCF, 0x8C, 0xB9, 0x08, 0x95, 
0xD5, 0xDF, 0x80, 0x32, 0x21, 0xF4, 0x84, 0xE1, 0xF7, 0xDF, 0x80, 0xE1, 0xF5, 0xDF, 0x08, 0x95, 
0x1F, 0x93, 0x18, 0x2F, 0xCB, 0xDF, 0x80, 0x32, 0x31, 0xF4, 0x84, 0xE1, 0xED, 0xDF, 0x81, 0x2F, 
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
0x90, 0x91, 0x67, 0x01, 0x28, 0x17, 0x39, 0x07, 0x38, 0xF3, 0x43, 0xC0, 0xF8, 0x94, 0xE1, 0x99, 
0xFE, 0xCF, 0x11, 0x27, 0xE0, 0x91, 0x64, 0x00, 0xF0, 0x91, 0x65, 0x00, 0xEE, 0x0F, 0xFF, 0x1F, 
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
}; // end of ATmegaBOOT_hex
