Pinoccio/test-backpack-wifi/(commit log)

2013-10-16 Initial import
    [wifi-test-middle.brd, wifi-test-top.brd, wifi-test.brd, wifi-test.sch]
2013-10-20 Updated wifi test suite code to test almost everything. WOOP! Also adding atmega board programmer code
2013-10-21 Fixed intermittent wifi flash chip write failure (removed dual calls to chip->info())
    [WifiTestSuite.ino]
2013-10-21 Add more fixes to flash chip
    [DriverFlashWriter.ino, WifiTestSuite.ino]
2013-10-26 Got both 256RFR2 and 16U2 flashable from driver scout, big progress!
2014-01-14 More Wifi test jig work--ability to write the four gainspan images to test jig driver flash
2014-01-26 Final fixups for wifi test jigs
    [WifiTestSuite.ino, WriteWifiToFlash.ino, programmer.cpp, programmer.h]
2014-02-17 In md5.c, include string.h for memcpy
    This prevents a compiler warning
    [md5.c]
2014-02-17 Use the Pbbe class for checksum calculations
    The crc functions previously used are no longer available under this
    name and using the functions from Pbbe removes the need to hardcode the
    CRC parameters in this code.
    [WifiTestSuite.ino]
2014-03-05 Clean up SPI chip select, fix SPI speed
    [WifiTestSuite.ino, WriteWifiToFlash.ino, flash_attiny13a.h, programmer.cpp, programmer.h]
2014-03-26 Slowed down the SPI clock for better reliability
2014-05-02 updated middle board hole size
    [wifi-test-middle.brd]
2014-05-23 Fix RgbLed to Led
    [wifi-test.brd]
2014-06-11 Update serial numbers and RgbLed->Led fix
    [WifiTestSuite.ino]
2014-06-11 Update attiny13 eeprom map to v1.1 for additional RDY pin
2016-03-17 Added some fixes to ensure SPI is shut off (for Gainspan serial flash init from gs_flashprogram.exe)
    [UpdateWifi.ino]
